samblenny/fruit-jam-code-practice-oscillator/NOTES.md

# Notes

Related Products and Learn Guides:
- https://www.adafruit.com/product/6200 (Fruit Jam)
- https://learn.adafruit.com/adafruit-fruit-jam/overview

Audio Docs & Examples:
- https://docs.circuitpython.org/en/latest/shared-bindings/synthio/
- https://github.com/todbot/circuitpython-synthio-tricks
- https://docs.circuitpython.org/projects/tlv320/en/latest/api.html
- https://docs.circuitpython.org/en/latest/shared-bindings/audiofilters/
- https://docs.circuitpython.org/en/latest/shared-bindings/audiomixer/

Morse Code References:
- ITU-R M.1677-1 International Morse Code
  https://www.itu.int/dms_pubrec/itu-r/rec/m/r-rec-m.1677-1-200910-i!!pdf-e.pdf
- Long Island CW Club (Koch Method curriculum, etc)
  https://longislandcwclub.org/curricula-introduction/
