samblenny/fruit-jam-code-practice-oscillator/morse_keys/mx-straight-key-2.stl

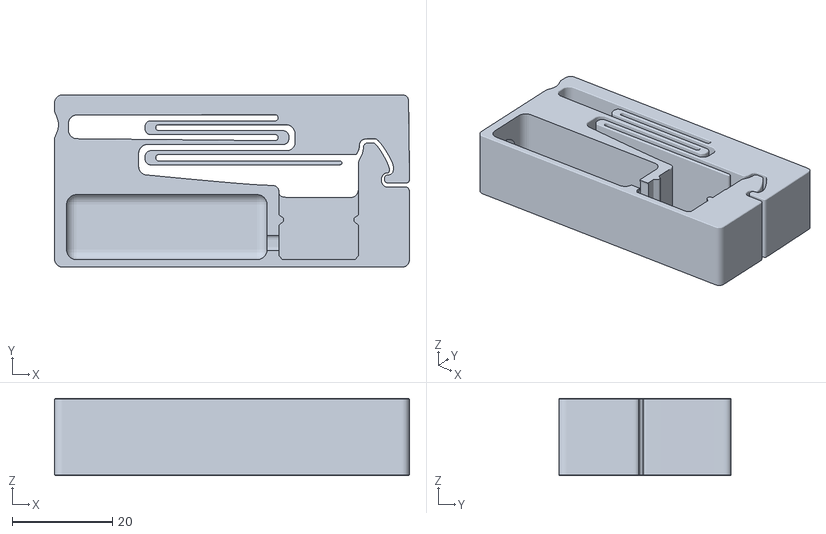
[picture p4: CAD file, 2026-01-06]
morse_keys/mx-straight-key-2.stl
70.8 x 34.4 x 15.4
