samblenny/fruit-jam-code-practice-oscillator/(list of files, cad)

Other CAD files:
morse_keys/mx-straight-key-2.blend
