samblenny/fruit-jam-code-practice-oscillator/(commit log)

2026-01-06 mx-straight-key rev2 3d-print stuff
    [mx-straight-key-2.blend, mx-straight-key-2.stl]
2026-01-06 code.py with temporary patched tlv320 driver
    A PR merged earlier today fixing the adafruit_tlv320 I2S DAC
    driver so it can do low-distortion 8000 Hz audio. Since the new
    driver is not in the library bundle yet, I'm temporarily including
    a copy of the patched driver here. I'll switch to the library
    bundle version once it becomes available.
    [bundle_manifest.cfg]
2026-01-06 add mx straight key wiring
2026-01-06 upgrade to latest library bundle
    This picks up the latest just-built-20-minutes-ago library bundle
    with the updated adafruit_tlv320 driver.
    [bundle_manifest.cfg]
2026-01-06 update wiring detail photo
    This one shows how the keyswitch and jack are connected.
2026-01-06 guide link for bundle manifest
    [bundle_manifest.cfg]
2026-01-07 add Button #3 support
2026-01-07 add metadata and icon to bundle
    [bundle_manifest.cfg]
2026-01-07 startup banner and volume instructions
    Changes:
    - Add comments about how to edit the code to switch from line
    level output volume to a reasonable headphone level (-24dB)
    - Add a startup banner that prints to the serial console with
    usage instructions, a note about how to set the volume, and a
    link to the Playground guide. This is meant to make it easier
    for people who find the code by way of Fruit_Jam_Library.
